Octav22/Stabilizator-de-tensiune-cu-ERS/Proiect docs/SERS_TUFAN_OCTAVIAN_IOAN_432E_DOCUMENTATIE.pdf

### Universitatea Națională de Știință și Tehnologie POLITEHNICA București

### Facultatea de Electronica , Telecomunicatii si Tehnologia Informatiei

### Referat : Etapa I

### Proiect 1 – Circuite electronice fundamentale 2

### Tema:

### Stabilizator de tensiune cu Element de Reglaj Serie

Tufan Octavian Ioan

Grupa : 432E

Bucuresti 2024

Date initiale de proiectare stabilizator de tensiune cu ERS:

- N=21;
- Tensiunea de iesire reglabila in intervalul: U0=(0,5N÷N)=(10,5÷21) V;
- Element de reglaj serie;
- Sarcina la iesire 50N[Ω]→RL=1050Ω
- Deriva termică < 2mV/0C;
- Protecție la suprasarcină prin limitarea temperaturii tranzistorului element de reglaj serie la 100°C, si a curentului maxim la 0,4A;
- Tensiune de intrare in intervalul : Ui=(1,8N÷2N)=(37,8÷42) V;
- Domeniul temperaturilor de funcționare: 00-700C (verificabil prin testare în temperatură);
- Amplificarea în tensiune minimă (în buclă deschisă) a amplificatorului de eroare: minim 200;
- Semnalizarea prezenței tensiunilor de intrare/ieșire cu diodă de tip LED.

Cerinte privind proiectarea:

- Dimensiunile PCB: 40mm x 40mm;
- Material FR4, dublu strat/ grosimea foliei de cupru 18 μm, grosimea plăcii 1,6 mm;
- Toate componentele se vor plasa pe faţa superioară a plăcii, TOP;
- Componente pasive SMD chip 0805;
- Se pot folosi numai tranzistoare bipolare şi TEC-MOS în capsule SMD (SOT 23, D PAK). Tranzistoarele TEC-J pot fi utilizate numai dacă se justifică necesitatea acestora.
- Puncte de test: dreptunghiulare, maxim 4 – justificate de planul de testare;
- Originea (punctul de coordonate (0,0)) va fi plasat în colţul din stânga-jos al plăcii de cablaj imprimat, astfel toate elementele proiectului vor avea coordonate pozitive;
- Faţă de marginea plăcii, se va păstra o gardare („clearance”) de 1 mm; aici nu vor fi plasate componente, trasee, texte, etc.;
- Placa va fi prevăzută cu 2 markeri fiduciali globali pe layerul TOP, la distanța de 200 mil față de marginea plăcii, plasați convenabil; acești markeri vor exista și pe layerul Solder Paste Top (suprapuși peste cei de pe TOP); vor fi utilizați în momentul alinierii șablonului cu placa. Marcajul fiducial va fi un cerc cu diametru de 1 mm pe layerul respectiv, aflat într-un spațiu circular de diametru minim dublu față de cercul interior, în care nu se va afla nimic pe nici un layer; 1 |6
- Se va acorda o atenţie sporită layer-ului Mască de inscripţionare (Silk Screen); acesta nu trebuie să se regăsească pe pad-urile componentelor;
- Se va genera un nou layer neelectric, MECANIC. Acesta va conţine: conturul plăcii, desenul de găurire („drill drawing”) şi tabelul de găurire („drill chart/table”, „drill legend”), o secţiune transversală prin circuitul imprimat proiectat („layer stack-up”) şi informaţiile mecanice necesare pentru fabricaţia PCB;
- Cotele de gabarit/dimensiunile plăcii nu trebuie să se regăsească pe layer-ul electric TOP; acestea, dacă există, se vor plasa pe un layer neelectric mecanic;

¨ Placa va fi prevăzută cu elementele de identificare ale proiectantului (nume, prenume, grupă, CEF2-P 2024-2025).

Pentru traseele de interconectare se dau următoarele lăţimi:

¨ Curent de 1A - 26 mil;

¨ Curent de sute de mA - 18 mil;

¨ Semnal - 16 mil.

Spaţierea, în toate cazurile, va fi de 14 mil.

Găurile de trecere pentru semnale (vias-uri) vor avea diametrul de 0,4 mm.

Fișierele Gerber - standard 274X şi fişierul Excellon trebuie să conțină următoarele informații:

¨ Conturul plăcii (board outline);

¨ Layer electric TOP;

¨ Layer electric BOTTOM;

¨ Layer neelectric Mască de inscripţionare (Silk Screen Top);

¨ Layer neelectric Mască de protecţie (Solder Mask Top și Bottom);

¨ Layer neelectric Şablon (Solder Paste Top);

¨ Lista de aperturi şi fişierul de găurire.

INTRODUCERE

Stabilizatorul de tensiune este un circuit electronic ce ofera la iesire o tensiune continua,constanta la variatiile(intre anumite limite) ale:

- Tensiunii de intrare : Δvi = vi ;
- Curentului de iesire (sarcinii) : ΔiO=-io ;
- Temperaturii: ΔT;

Stabilizatorele liniare serie sunt circuite la care elemetul de reglaj actioneaza continuu pentru a avea o tensiune constanta la iesire.

In structura lor apar cel putin doua subcircuite :

- Referinte de tensiune (REF) , acesta asigura o tensiune constanta la bornele sale pentru un domeniu restrains al curentului de iesire.
- Blocul de comanda si reglaj serie, compus dintr-un element de reglaj serie (ERS) si un amplificator de eroare. ERS se comporta ca o rezistenta ce isi modifica valoarea in functie de tensiunea de intrare.

SCHEMA BLOC:

- Refereinta de tensiune;
- Amplificator de eroare;
- Element de reglaj serie implementat PNP;
- Rețea de reacție negativă;
- Circuit de protectie la suprasarcina;
- Circuit de protectia la temperatura;

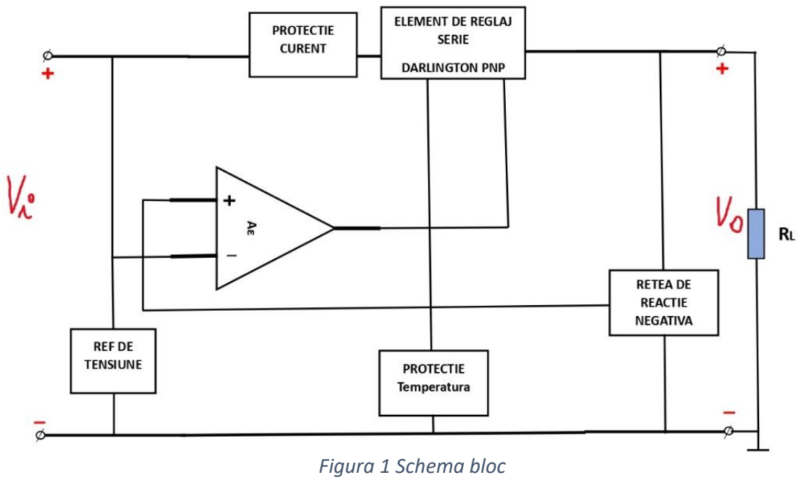
[picture p1: figure]
Figura 1 Schema bloc

DETALII DE PROIECTARE A STABILIZATORULUI:

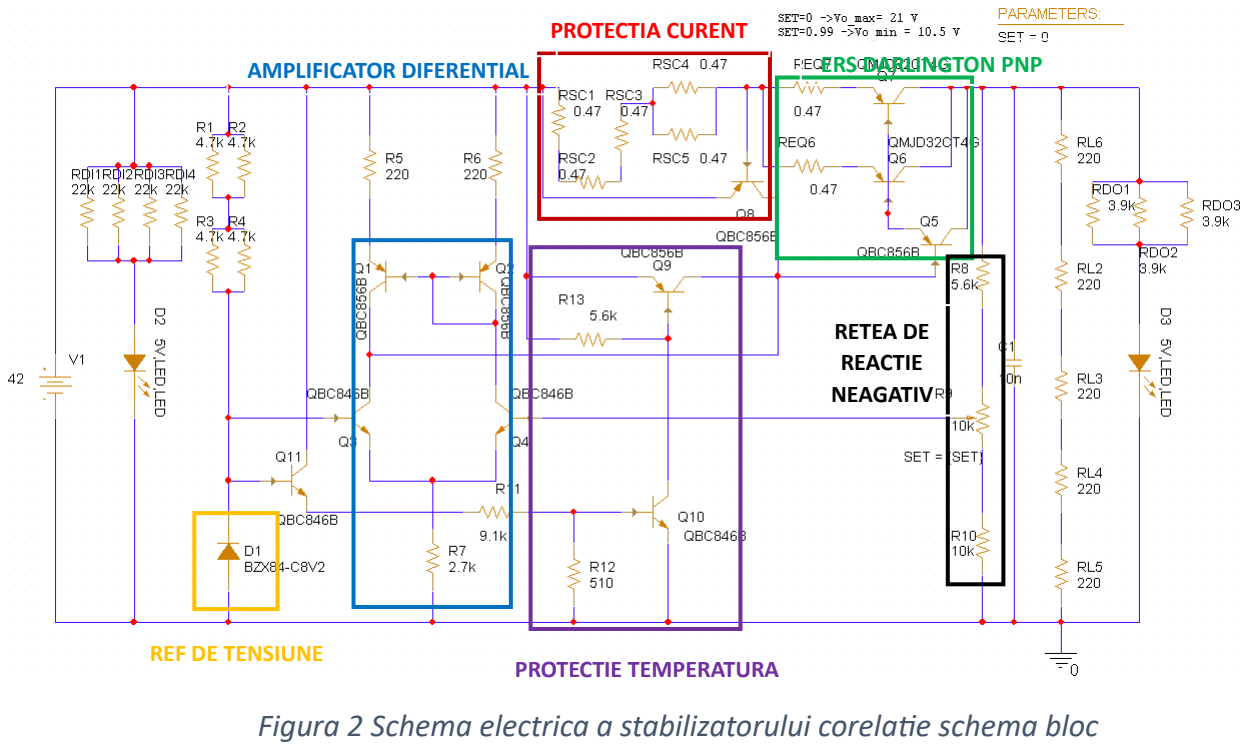
[picture p2: figure]
PROTECTIA CURENT; PROTECTIE TEMPERATURA; RETEA DE REACTIE NEAGATIV; REF DE TENSIUNE

Circuitul este compus din urmatoarele blocuri:

¨ Amplifcator diferential de eroare: Q1,Q2,R5,R6 Q3,Q4,R7; ¨ Referinta de tensiune: D2;
¨ Retea de reactie negativa: R8,R13,R9;
¨ Regulator serie: Q5,Q6,REQ6,Q7,REQ7;
¨ Protectie la suprasarcina: RSC1,RSC2,RSC3,RSC4,RSC5,Q8; ¨ Protectie Termica: Q9,R12,Q10,R11,R10,Q11;
¨ Led intrare: D3,RDI1, RDI2, RDI3, RDI4, RDI5, RDI6;
¨ Led iesire: D4,RDO1, RDO2, RDO3, RDO4;
AMPLIFICATOR DIFERENTIAL | ERS DARLINGTON PNP

Figura 2 Schema electrica a stabilizatorului corelatie schema bloc

Prezentarea alegerii modelelor de rezistoare,tranzistoare si diode:

1.Referinta de tensiune:

Este data de dioda Zener D2 de 8.2V. Dioda se polarizea in current prin gruparea echivalenta RE1 realizata din rezistentele R1,R2,R3,R4. Rezistoarele se aleg astfel incat puterea disipata pe acestea sa nu depaseasca valoarea de 0.125mW, vrem o putere apropiata de 50% din Pmax a acestora pentru a nu incalzi prea rapid.

Se alege dioda : Cod BZX84C8V2 , SMD , SOT 23 , Vz = 8,2V , ± 5% , 0,25W,Izmin=5 mA.

RE1 se alege astfel incat dioda sa intre in strapungere Iz>Izmin.

2.Amplificatorul diferential de eroare:

Vrem ca prim pas sa testam daca Dioda Zenner D2 este in strapungere la V1=V1max & V1=V1min;

RE1 = R1||R2 + R3||R4 = 4,7k

−V1 + Recℎiv ∗ Iz + Vz = 0

Iz’ =

V1′ − Vz
RE1

=

42V − 8,2V
4.7k

=

33,8V
4.7k

= 7,19mA

RE1

Figura 3 Referinta de tensiune

Iz′′ =

V1

′′ − Vz
RE1

=

37,8V − 8,2V
4.7k

=

29,6V
4.7k

= 6,29mA

=>Dioda este in strapungere in ambele cazuri.

Alfam curentul din emitorul lui Q3 si Q4:

Q3 si Q4 se aleg ca tranzistoare NPN de mica putere modelul BC846B, nu ar trebuii sa avem puteri mari pe acestea.

−Vz + VBE3 + R7 ∗ IE=0

IE =

Vz−VBE3
R7

=

8,2V−0.6V
2,7k

= 2,81mA

IE = IC1 + IC2

IC1=IC2,deoarece avem o oglinda de current formata din Q1 ,Q2 si rezistentele R5,R6.

Alegem Q1,Q2 ca tranzistoare PNP de mica putere modelul BC856B, puterea disipata pe cele doua tranzistoare va fi de valori mici.

=> IE = 2IC => IC =

IE
2

=

2,81mA
2

= 1,4mA

Vrem sa alegem rezistentele R5,R6 astfel incat sa nu blocheze tranzistoarele din oglinda,cele care seteaza curentii IC1 si IC2.

SCHEMA ELECTRICA A AMPLIFICATORULUI DIFERENTIAL IN BUCLA DESCHISA:

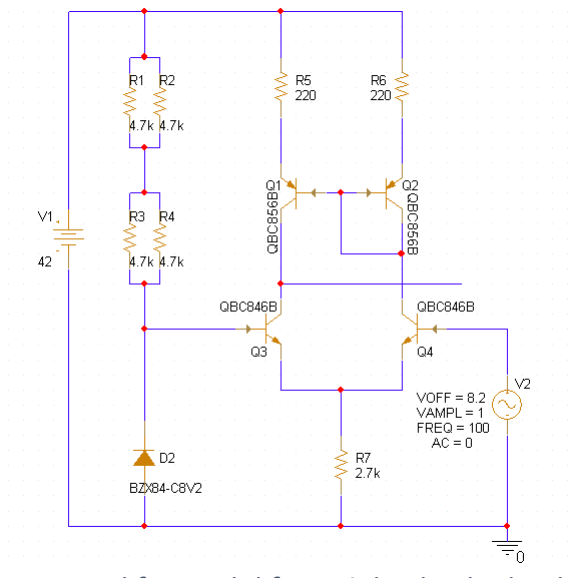
[picture p3: figure]

Figura 4 Amplifcatorul diferential in bucla deschisa

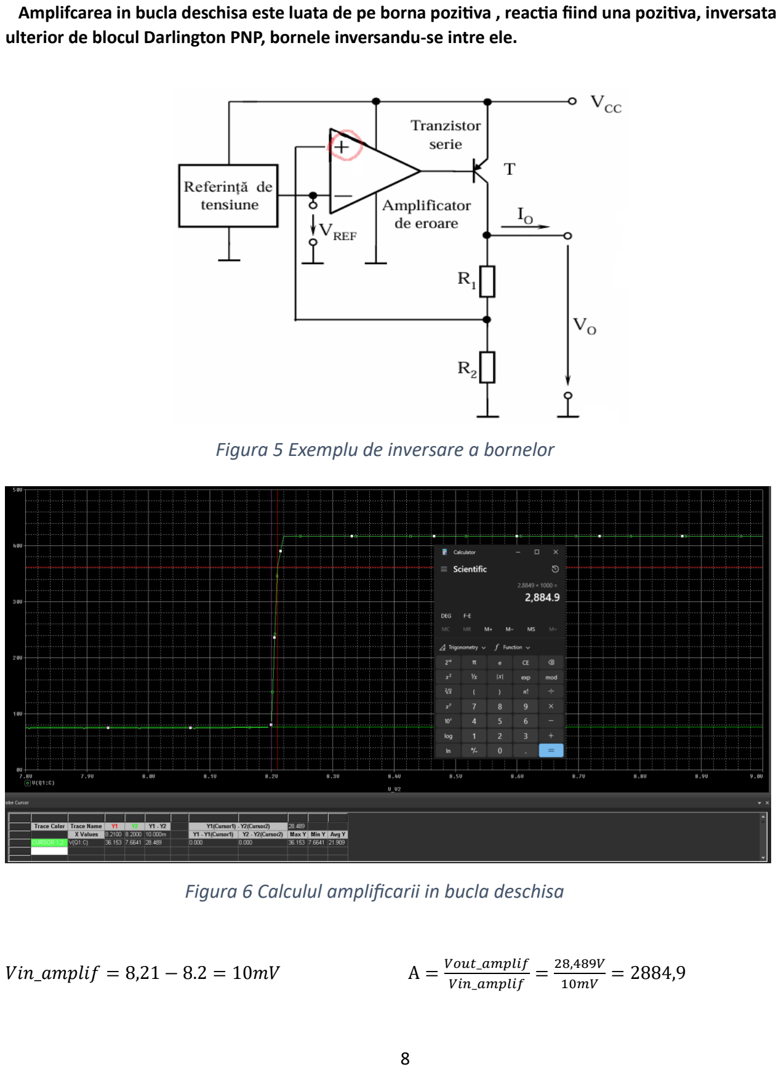
[picture p4: page 8]

Amplifcarea in bucla deschisa este luata de pe borna pozitiva , reactia fiind una pozitiva, inversata ulterior de blocul Darlington PNP, bornele inversandu-se intre ele.

Vin_amplif = 8,21 − 8.2 = 10mV | A =

Vout_amplif
Vin_amplif =

28,489V
10mV

= 2884,9

Figura 5 Exemplu de inversare a bornelor

Figura 6 Calculul amplificarii in bucla deschisa

3.Reteaua de reactie negativa:

Aceasta este un divizor rezistiv format din rezistentele R8,R9,R10. R9 este potentiometrul reglabil, acestea se aleg convenabil pentru a ajunge la intrarea negativa a amplificatorului de eroare diferential aproape egal cu ce este la cea pozitiva unde este aflata tensiunea de referinta .

Am ales R9 potentiometru de 10k modelul 3314G-1-103E de la BOURNS.

Tensiunea de pe R10 este o fractiune din tensiunea de iesire.

Vfo = Vo

R10
R10 + R8

La valoarea SET=1 ,rezistenta R13 se va duce toata catre ground adica pe R10, iar la SET=0, rezistneta R13 se va duce catre VCC ,catre R8.

Am ales R8=5.6k modelul 0805S8J0562T5E de la ROYAL OHM ,iar R9=10k modelul 0805S8J0103T5E tot de la ROYAL OHM.

4.Regulator Serie:

Elementul de reglaj serie este alcatuit din tranzistoarele Q5,Q6,

,Q7 si rezistoarele din emitorul lor.

Tranzistorul Q5 este conectat la iesirea amplificatorului diferential ,acesta a fost ales PNP pentru a inversa bornele amplificatorului ,facand din reactive pozitiva reactie negativa, emitorul lui Q5 este conectat in baza gruparii dintre Q6 si Q7,acesti doi tranzistori formeaza unul echivalent, emitorul lui Q6 este conectat la Vin prin REQ7. Emitorul lui Q7 este conectat prin REQ7 LA Vin. Colectorul lui Q6 este conectat la colectorul lui Q7,bazele fiind de asemenea conectate intre ele, aceasta formatie creeaza un transistor Echivalent ce are ca rol injumatatirea puterii de pe tranzistori.
Tranzistorul echivalent si tranzistorul Q5 modelul QBC546B de mica putere, formeaza astfel gruparea Darlington implementata cu tranzistoare PNP, care este elemental de reglaj serie.

Figura 7 Reteaua de reactie negativa

Q7,Q6 au fost alese tranzistoare de putere modelul MJD32CG de la ON Semiconductor, au fost alese de putere pentru ca in cazul unui scurtcircuit sau a unui test cu o sursa de curent la un curent mai ridicat o sa avem niste puteri foarte mari pe acestia.

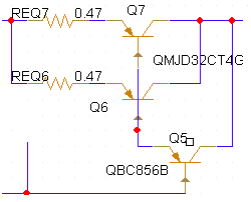
[picture p5: figure]

### 5. Protectie la suprasarcina:

Este formata din RSC si tranzistorul Q8 PNP de mica putere modelul QBC546B de mica putere, ,acesta are rolul sa limiteze curentul maxim de la iesire la 0,4mA. Aceasta limiteaza curentul din baza Darlington-ului.

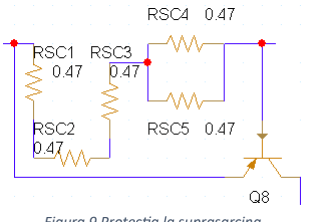
[picture p6: figure]

Testul la suprasarcina se face utilizand o sursa de curent la iesire si punand in locul rezistentei de sarcina o rezistenta mare de valori peste 100kohm. Putem testa prin simulare de tip PSF , punand o valoare de peste 400mA sursei de curent I1 sau prin DC SWEEP la aceasta.

Figura 8 Elementu de reglaj serie

Figura 9 Protectia la suprasarcina

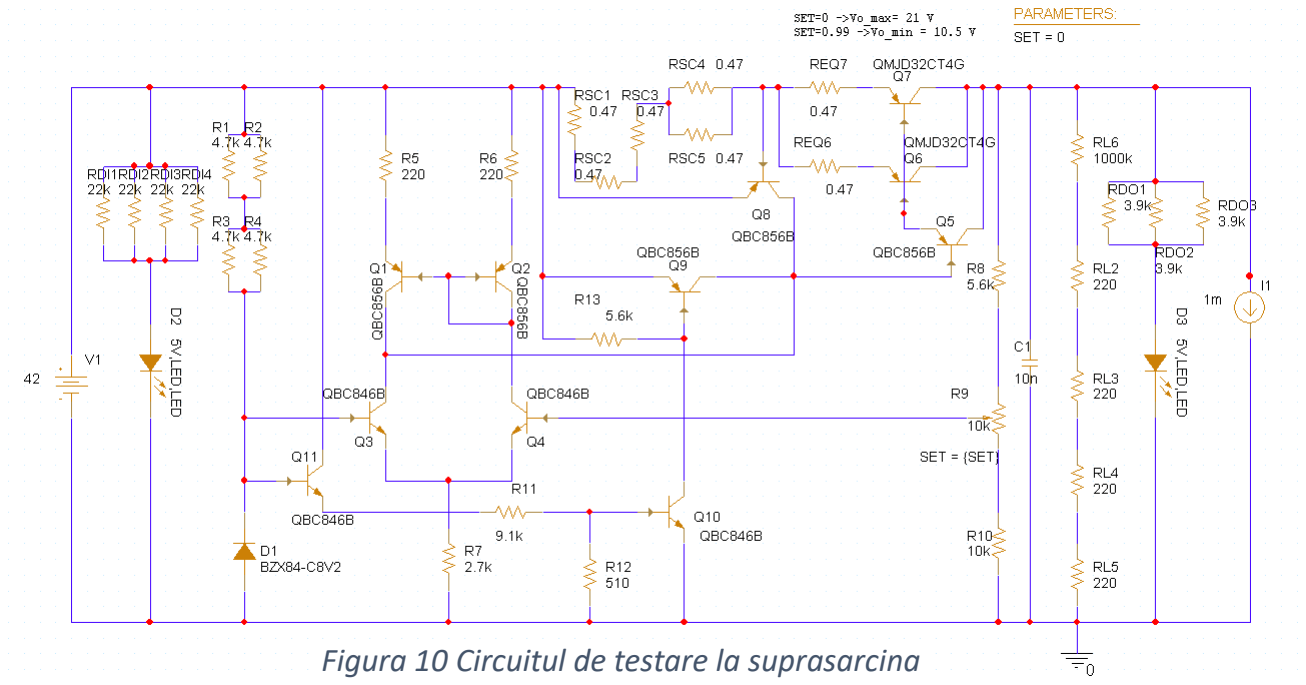
[picture p7: figure]

### 5. Protectie Termica:

Formata din Q9 tranzistor de mica putere PNP modelul QBC546B ,R12,Q10 NPN de mica putere modelul QBC546B, R12, R11, R10 , Q11 NPN de mica putere modelul;

Q11 este un repetor de tensiune al tensiunii de referinta ,rezistorii R11,R10 formeaza un divizor rezistiv ,vrem sa avem in acel potential aproximativ 400mV, pentru a deschide tranzistorul Q10 care este legat de baza lui Q11, emitorul lui Q 11 este conectat la Vin,iar colectorul in baza Darlington-ului,acesta trebuie sa ridice baza Darlington-ului pentru a opri circuitul in momentul in care se detecteaza o temperatura de 100 de grade.

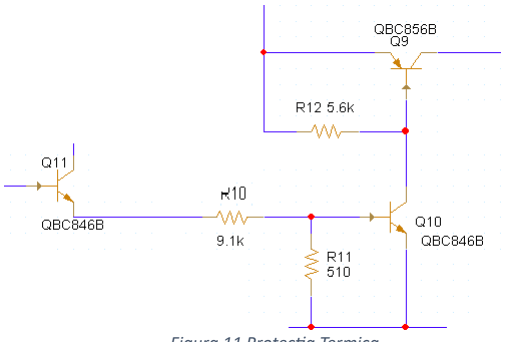
[picture p8: figure]

Figura 11 Protectia Termica

Figura 10 Circuitul de testare la suprasarcina

### Calculul derivei termice/Tensiunea de iesire in functie de temperatura

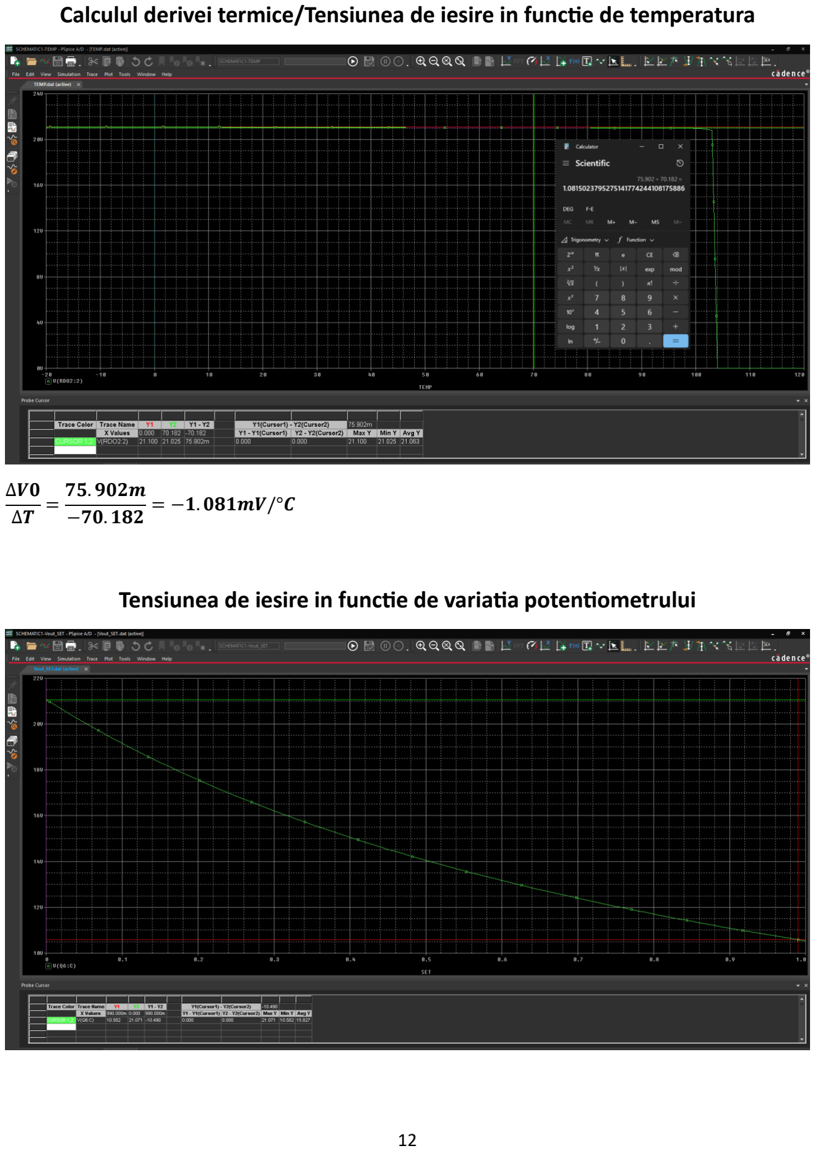
[picture p9: page 12]

∆V0
∆T

=

75. 902m
−70. 182 = −1. 081mV/°C

### Tensiunea de iesire in functie de variatia potentiometrului

### DEMONSTRATIA ALEGERILOR MODELELOR

### CALCULUL ANALITIC

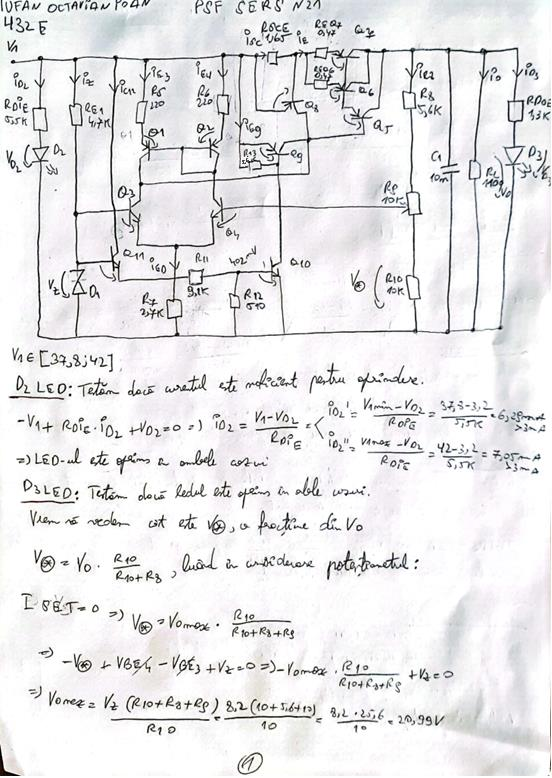
[picture p10: figure]
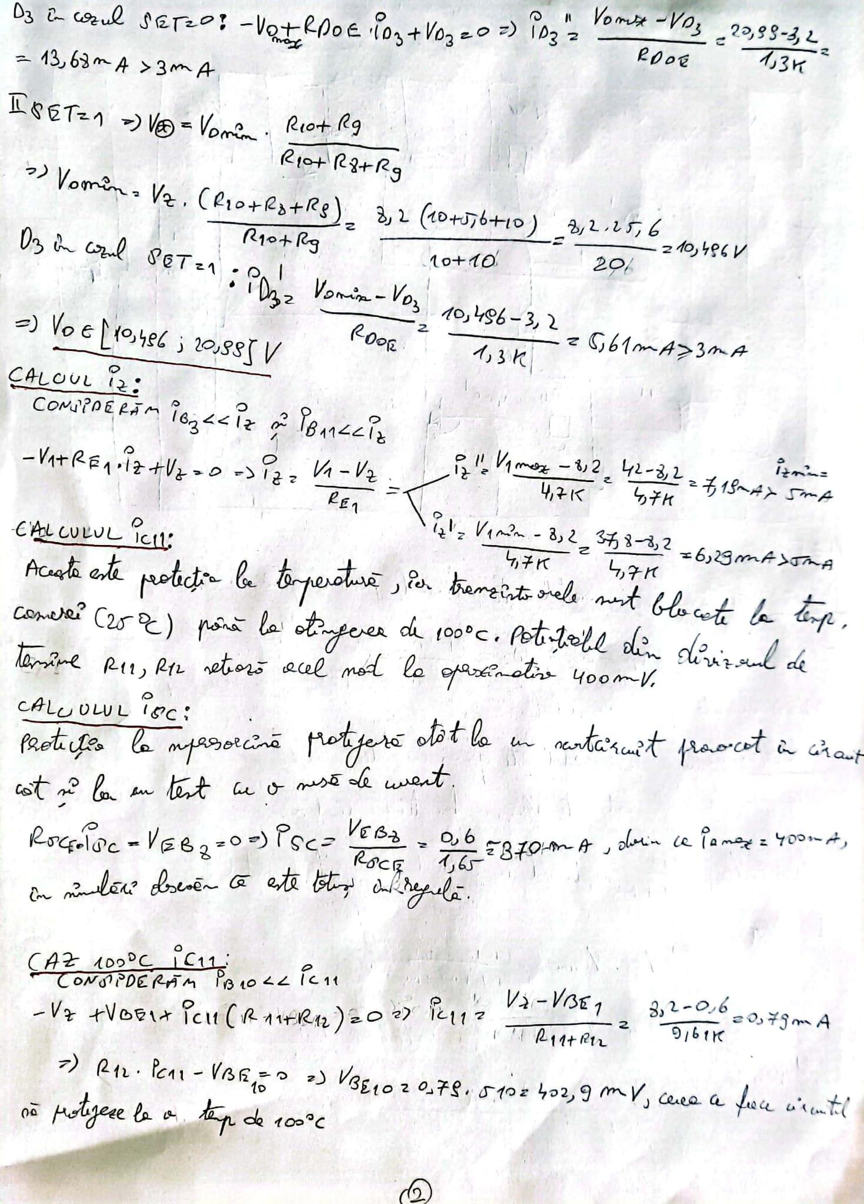
[picture p11: page 14]
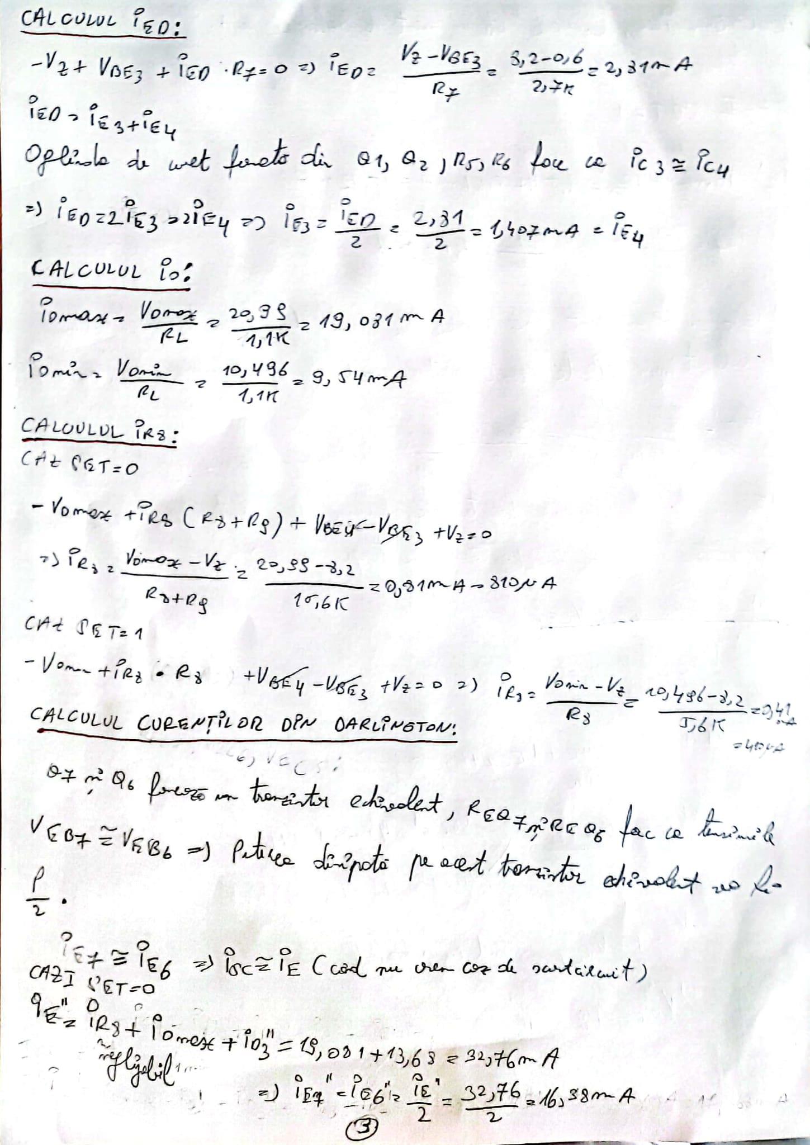
[picture p12: page 15]
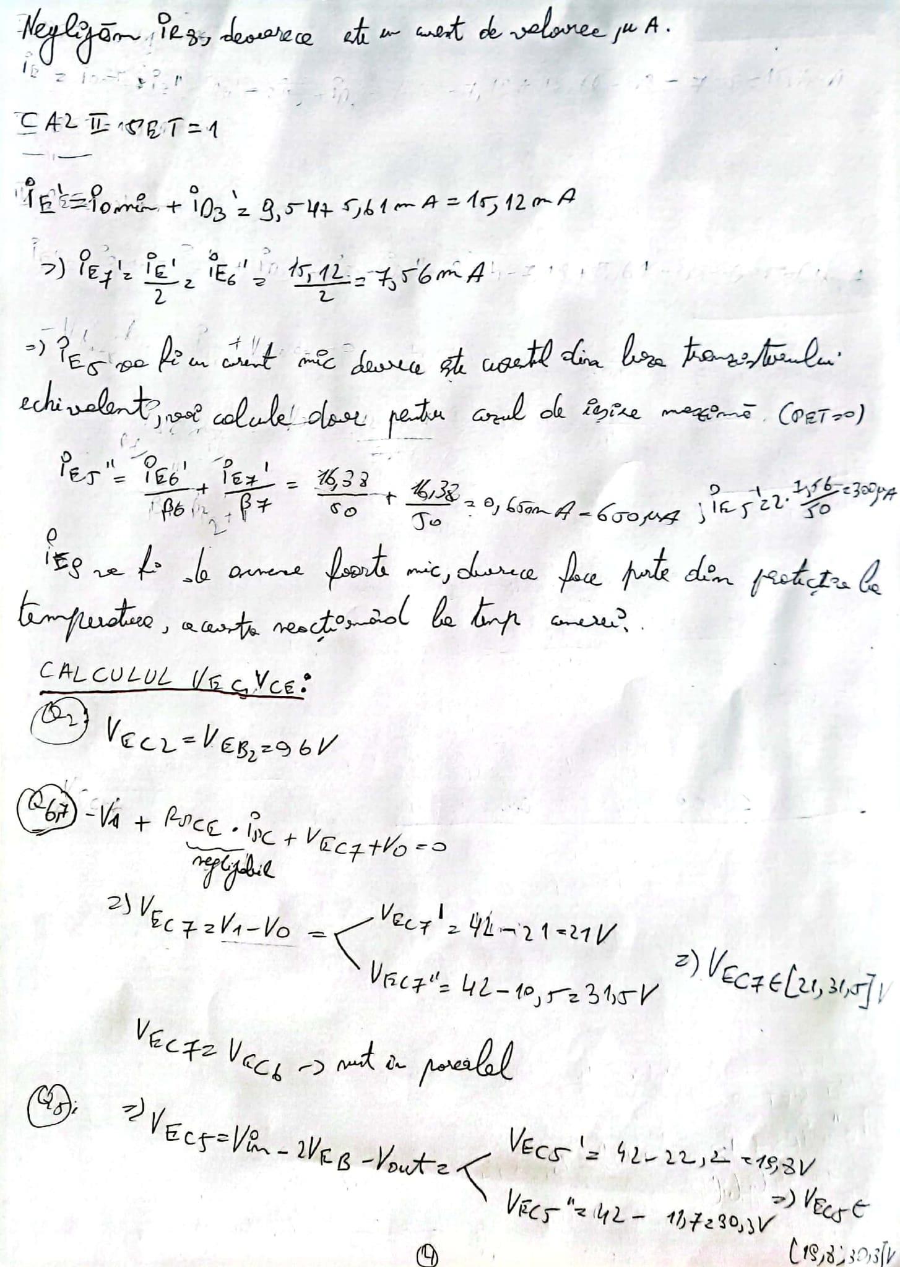
[picture p13: page 16]
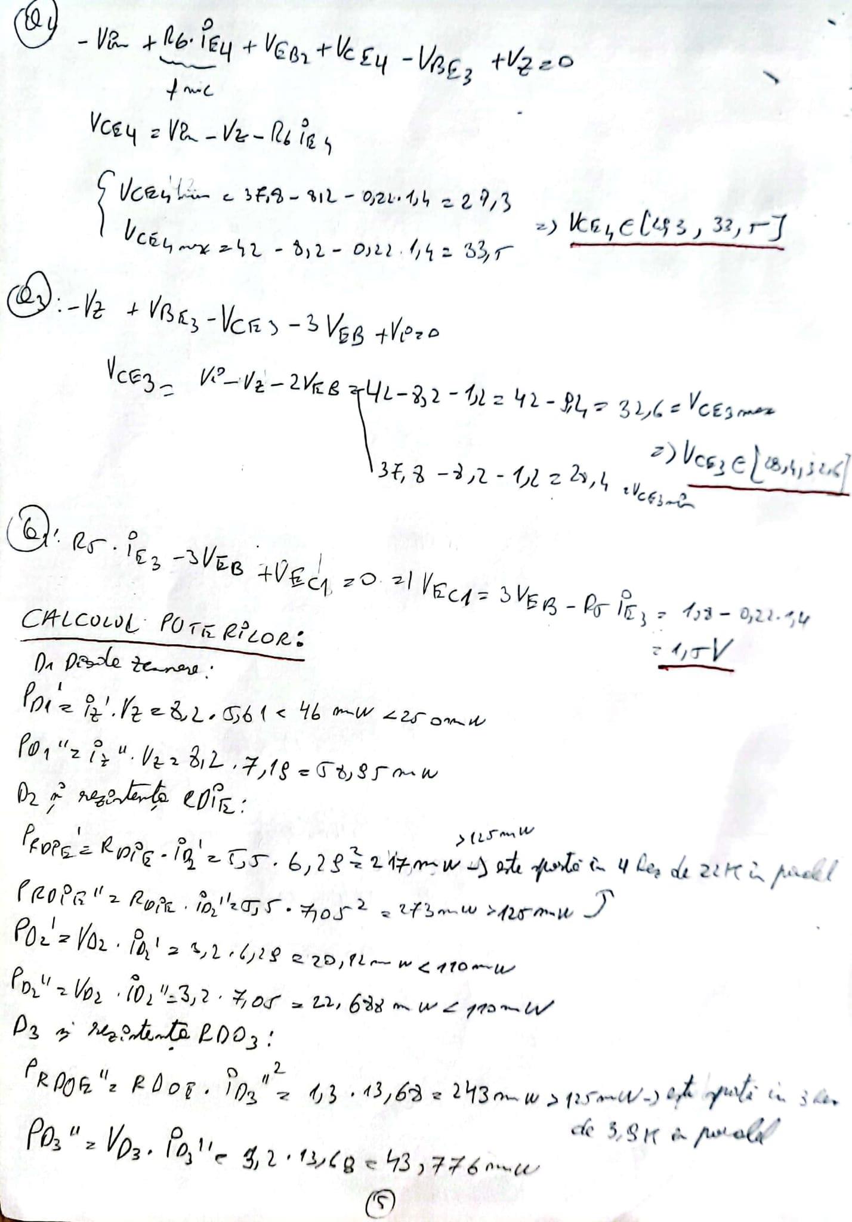
[picture p14: page 17]
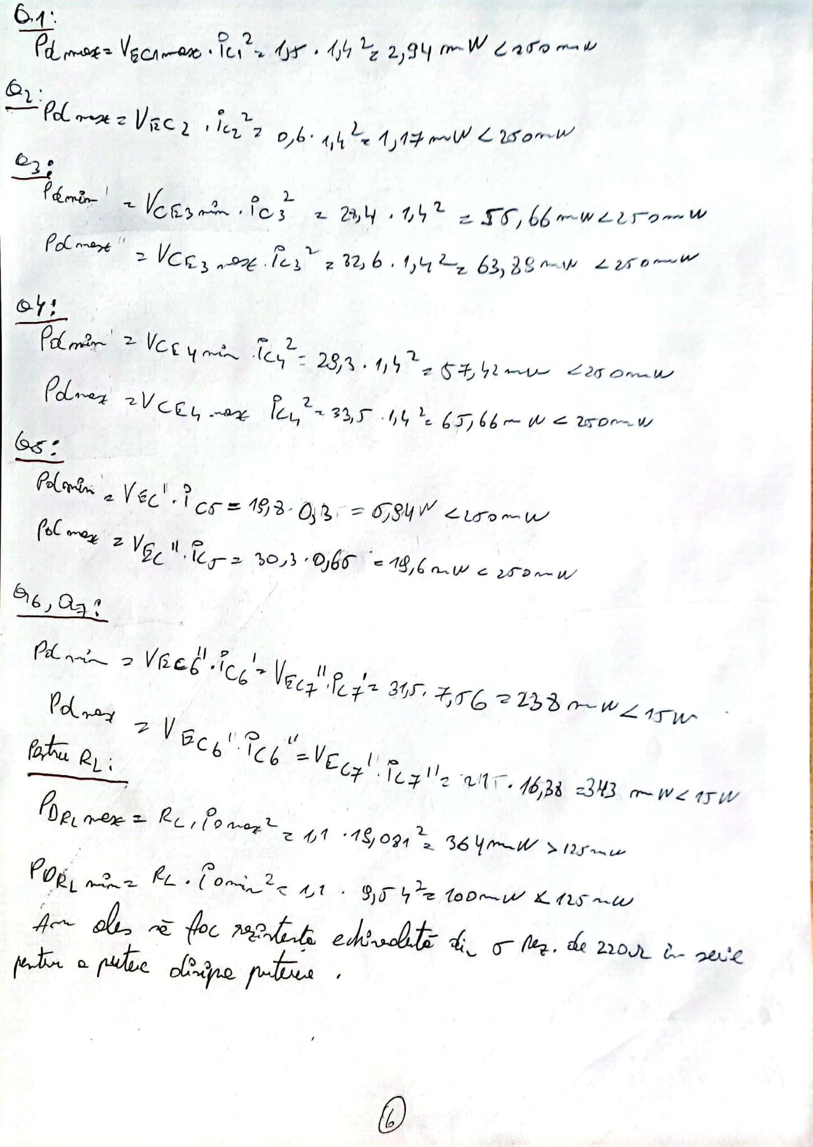
[picture p15: page 18]
