Octav22/Stabilizator-de-tensiune-cu-ERS/Layout/sers n21 pcb.jpg

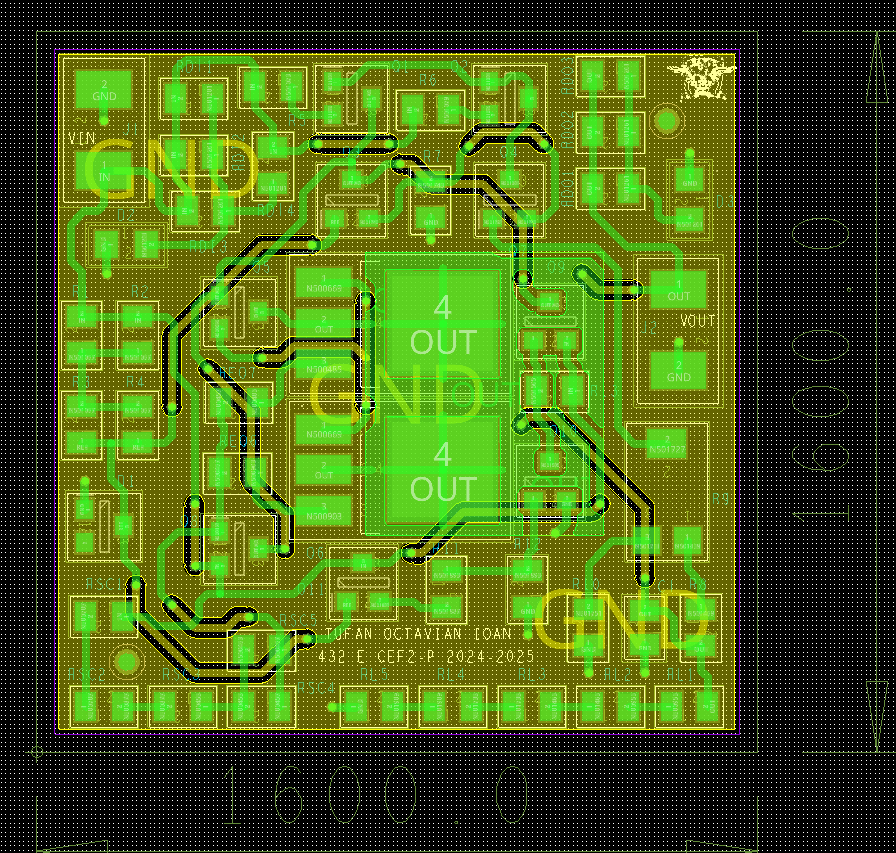
Layout/sers n21 pcb.jpg
