Octav22/Stabilizator-de-tensiune-cu-ERS/schema_bloc.jpg

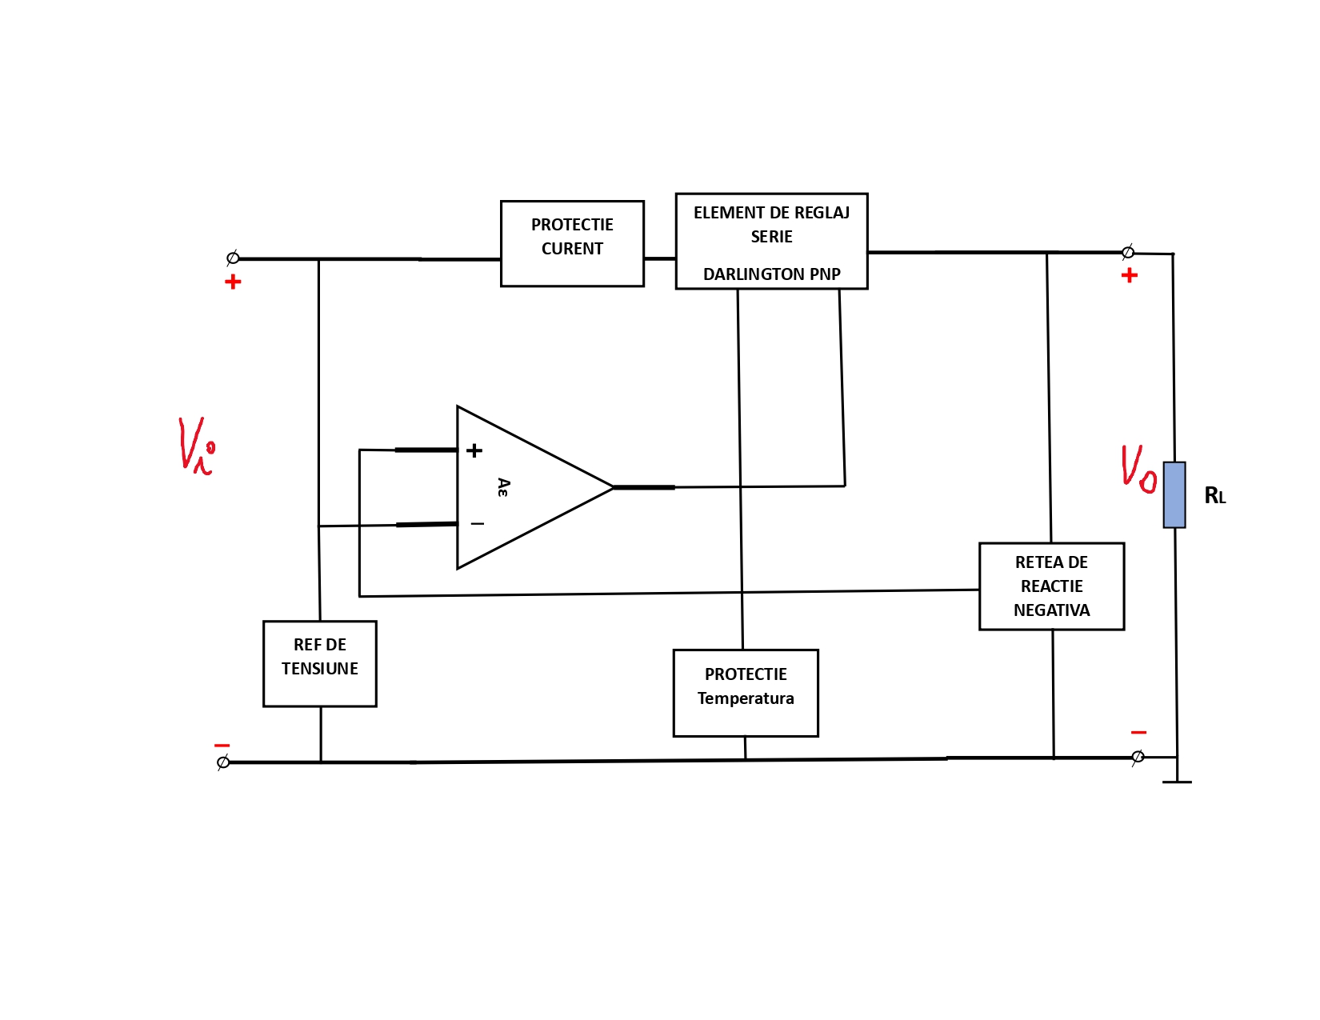
schema_bloc.jpg
