Octav22/Stabilizator-de-tensiune-cu-ERS/Schematics/Circuit.jpg

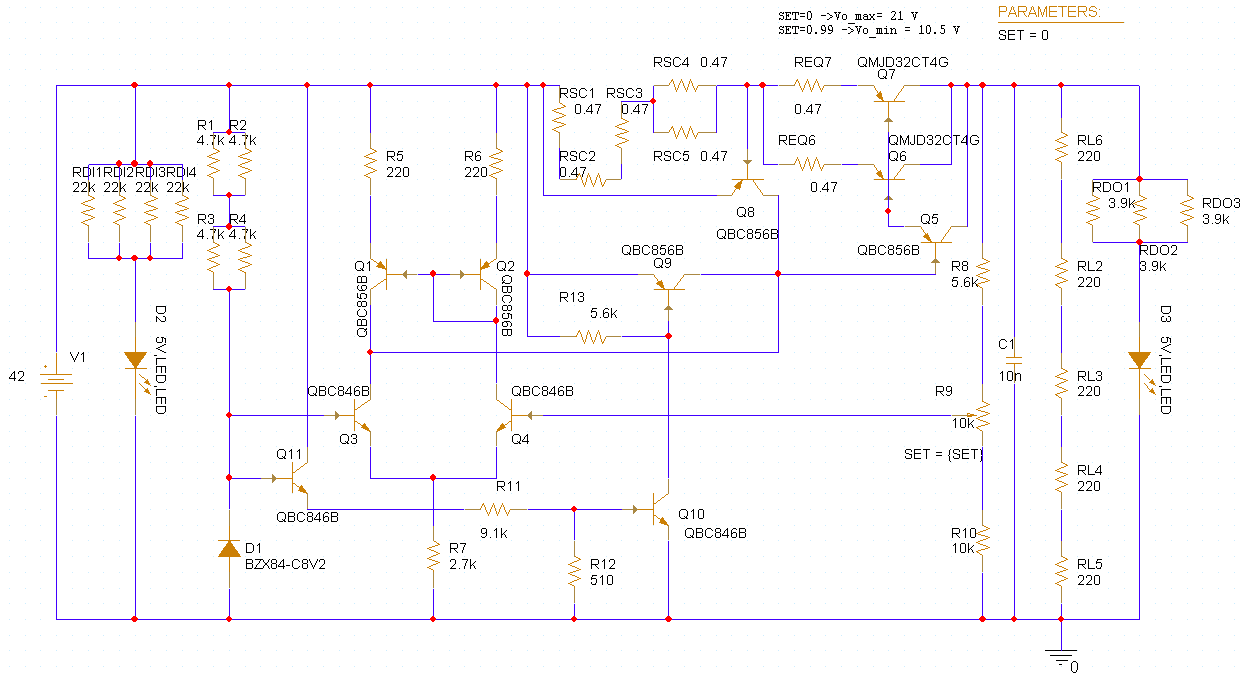
Schematics/Circuit.jpg
