Octav22/Stabilizator-de-tensiune-cu-ERS/Schematics/SERS N21/SERS N21-PSpiceFiles/SCHEMATIC1/IoMax/IoMax.cir

** Profile: "SCHEMATIC1-IoMax"  [ C:\Users\octav\Desktop\P1_2024_432E_TUFAN_OCTAVIAN_IOAN_SERS_N21_ORCAD\Schematics\SERS N21\sers n21-pspicefiles\schematic1\iomax.sim ] 

** Creating circuit file "IoMax.cir" 
** WARNING: THIS AUTOMATICALLY GENERATED FILE MAY BE OVERWRITTEN BY SUBSEQUENT SIMULATIONS

*Libraries: 
* Profile Libraries :
* Local Libraries :
.LIB "../../../lib/bc846b.lib" 
.LIB "../../../lib/bc856b.lib" 
.LIB "../../../lib/bzx84c8v2.lib" 
.LIB "../../../lib/mjd32cg.lib" 
* From [PSPICE NETLIST] section of C:\SPB_Data\cdssetup\OrCAD_PSpice\24.1.0\PSpice.ini file:
.lib "nom.lib" 

*Analysis directives: 
.DC LIN I1 0 420m 0.01 
.OPTIONS ADVCONV
.PROBE64 V(alias(*)) I(alias(*)) W(alias(*)) D(alias(*)) NOISE(alias(*)) 
.INC "..\SCHEMATIC1.net" 


.END
