Octav22/Stabilizator-de-tensiune-cu-ERS/(list of files, drawings)

Other design files:
Schematics/SERS N21/AMPLICARE_IN_BUCLA_DESCHISA.DSN
Schematics/SERS N21/Amplicare_in_bucla_deschisa.opj
